licj15/Infrared_photoelectric_transmission/(list of files, drawings)

Other design files:
用户端.ms12
电表端.ms12
